planedoctor/ESP32-Mailbox/README.md

# ESP32-Mailbox
A notification system for alerting via email that your physical mailbox was opened.  This project uses a wireless doorbell, limit switch, and a ESP32.
