planedoctor/ESP32-Mailbox/ESP32 Mailbox Schematic.pdf

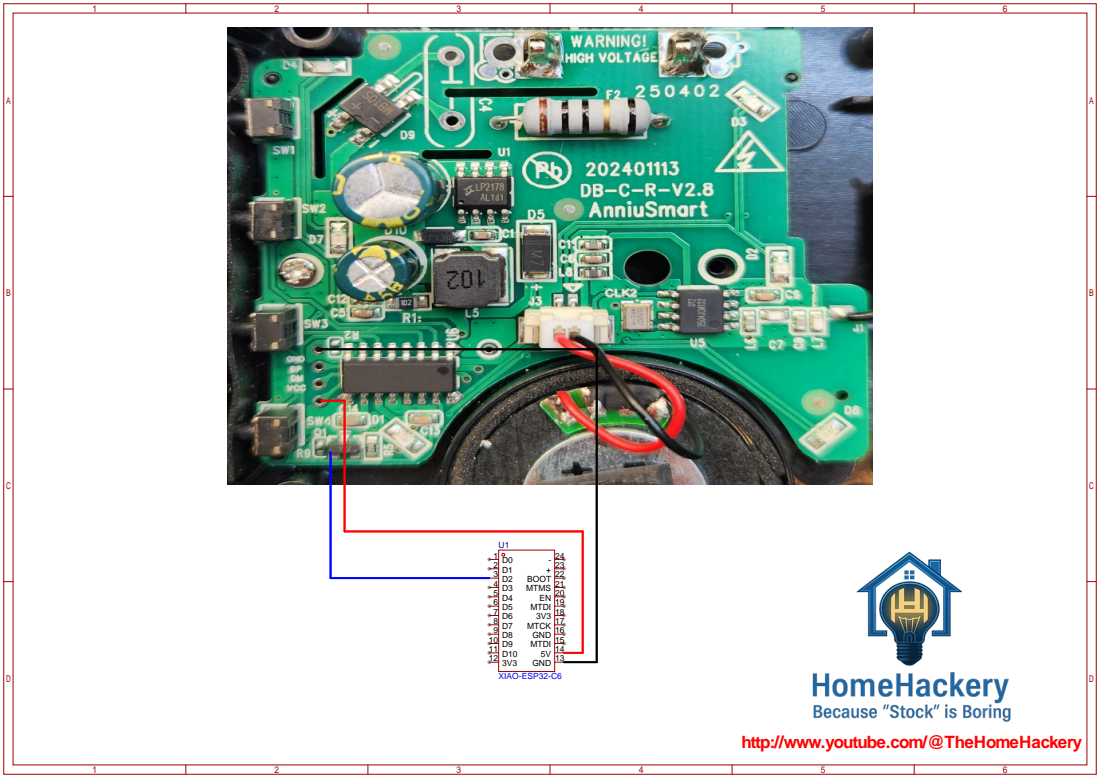
[picture p1: page 1]

http://www.youtube.com/@TheHomeHackery

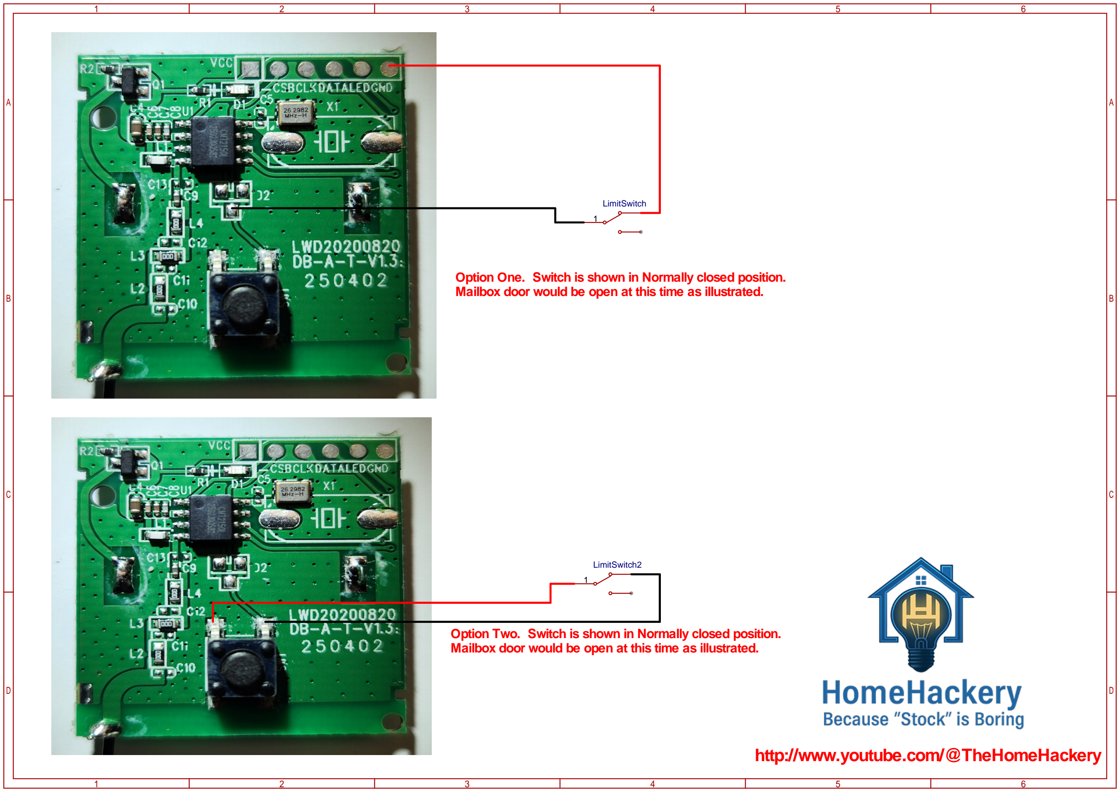
[picture p2: page 2]

## http://www.youtube.com/@TheHomeHackery

1

LimitSwitch

Option One. Switch is shown in Normally closed position. Mailbox door would be open at this time as illustrated.

1

LimitSwitch2

Option Two. Switch is shown in Normally closed position. Mailbox door would be open at this time as illustrated.
