planedoctor/ESP32-Mailbox/(commit log)

2025-12-16 Add files via upload
    Please edit Wi-Fi credentials, time zone, input pin. Possible changes to board input and location of LED.
2025-12-16 Add files via upload
    Wiring schematics for mailbox limit switch to transmitter and ESP32 connections to receiver.
2026-01-03 Add files via upload
    After time the ESP32 was not reconnecting with WIFI and sending emails. This fix corrected these issues by adding:
    WiFi Self-Healing: Added a verifyWiFi() function that runs once a minute and immediately before sending an email. If the connection to your router is lost, the XIAO ESP32C6 will automatically attempt to reconnect.
    Connection Lifecycle: Changed the email logic to open the connection only when a pulse train is detected and explicitly close it after the email is sent using smtp.closeSession(). This prevents the Gmail server from timing out your device for an idle, hanging connection.
    Memory Management: Added message.clear() to free up RAM after each t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
    [ESP32_Mailbox1.0.1.ino]
